xandreeddev/parametric-switch-rack/exports/default_1u_mount.3mf

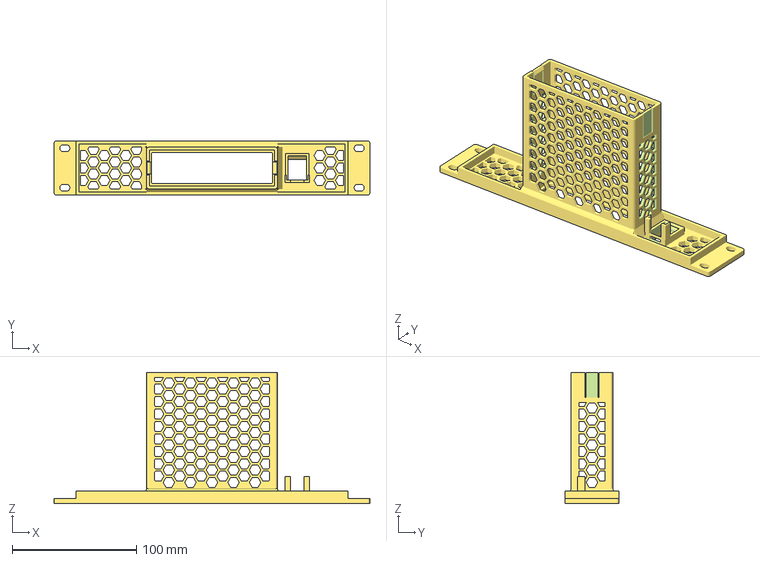
[picture p11: CAD file, 2026-10-14]
exports/default_1u_mount.3mf
254.0 x 43.6 x 105.4 mm
