xandreeddev/parametric-switch-rack/exports/keystone_coupon_goobay_96100.3mf

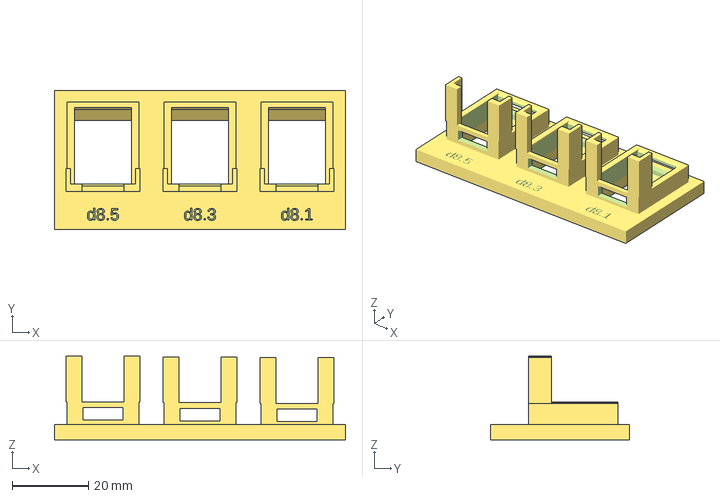
[picture p12: CAD file, 2026-10-14]
exports/keystone_coupon_goobay_96100.3mf
76.5 x 36.5 x 22.0 mm
