xandreeddev/parametric-switch-rack/(commit log)

2026-10-13 Parametric 10-inch rack switch mount for KWS Rack V2
    One self-contained OpenSCAD file for MakerWorld's Parametric Model Maker:
    an EIA-310 10" panel (1U-6U, M5 slots on the KWS insert pattern) with a
    ventilated enclosure sized from the switch's measured dimensions, and
    snap-in keystone couplers (Goobay 90866 preset, generic and custom).
    - retention: rear-loaded bezel + snap clips or screw brackets, friction,
    or front loading against a printed rear stop
    - honeycomb / diamond / grid / round mesh on the faceplate and enclosure,
    regenerated around the switch and couplers
    - test pieces: keystone coupon, switch clearance ring, rack alignment frame
    - validation stops with the reason instead of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
    [default_1u_mount.3mf, keystone_coupon_goobay_90866.3mf, parametric_switch_rack.scad]
2026-10-13 Snap-in keystone holders, KWS pattern library, five-step customizer
    - RJ45 couplers now snap into a proper keystone frame: a 7.8 mm tunnel whose
    rear edge catches the latch and hook, plus a support cradle with a hook
    groove behind it. The coupler face sits flush; the coupon steps the frame
    depth (7.5/7.8/8.1) instead of a plate thickness.
    - Customizer opens with five groups (panel size, switch size, couplers
    left/right, pattern, what to print); everything else moved to Advanced.
    - 15 patterns matching the KWS Customizable generators (offset/kite
    diamonds, X, pluses, slots, Skadis, hearts, rounded hearts, heart lattice,
    trilobes, tech squares) with their controls: rotation, area p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
    [default_1u_mount.3mf, keystone_coupon_goobay_90866.3mf, parametric_switch_rack.scad]
2026-10-13 README: show print orientation, drop unused renders
2026-10-14 Rear-loaded keystone holders modelled on the metal keystone frame
    Keystone couplers clip into their frame from behind: the latch and the
    fixed hook have their catch faces 8.1 mm behind the coupler face and
    lock behind a 1.5 mm lip, while side stops rest on the frame's rear end.
    The previous holder assumed front loading and had nothing for the
    barbs to catch on.
    Each holder is now a 9.8 mm tunnel with latch and hook windows, the
    catch lip at 8.3 mm, a 45 degree front lip and a rear lead-in, plus an
    L-rail cradle that leaves room for the hook. Adds the Goobay 96100
    (slim) preset as the default, replaces the nominal STP/UTP presets with
    one generic preset, and reworks the coupon (catch lip 8.1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
    [default_1u_mount.3mf, keystone_coupon_goobay_90866.3mf, keystone_coupon_goobay_96100.3mf, parametric_switch_rack.scad]
2026-10-14 Fix the coupler dropdown and explain unknown setting values
    A colon inside the "Custom" label stopped the customizer from parsing
    the keystone_preset options, so the coupler model showed no list. Labels
    now avoid colons and brackets (the parser drops brackets anyway).
    An output, coupler or pattern value the model doesn't know used to give
    "Current top level object is empty" with no reason; it now stops with a
    message listing the valid values.
    [parametric_switch_rack.scad]
2026-10-14 Patterned or open enclosure side walls
    Small switches vent through their sides, so the enclosure side walls now
    carry the pattern by default. cage_sides = open cuts one window per side
    with a 45 degree pointed rear end (no bridge); solid keeps the old walls.
    The snap-clip tongues, crush rib strips and screw bosses keep their wall
    in every mode, as do the edges and the gusset zone at the panel.
    [default_1u_mount.3mf, parametric_switch_rack.scad]
